hanezzzz00/dspi-pico2-diy/sticker/DSPi_bottom_sticker_QR_CZ.pdf

## DSPi – samolepka na dno krabičky (QR kód na návod)

Tiskněte ve SKUTEČNÉ VELIKOSTI (100 %), ne „přizpůsobit stránce“. Kontrolní měřítko dole musí mít přesně 50 mm. Velká samolepka má tvar dna krabičky (70,8 × 68,8 mm); rohové výřezy 10 × 10 mm jsou místo pro gumové nožičky. Potisk je 2 mm od řezu – okraj pro přesah laminovací fólie. Zalaminujte, pak stříhejte po přerušované čáře.
QR kód má zvýšenou korekci chyb (Q), přečte se i přes lesklou fólii. Před nalepením ho vyzkoušejte telefonem. Malé samolepky dole: jen QR kód, např. na kabel, krabičku od dílů nebo do šuplíku.

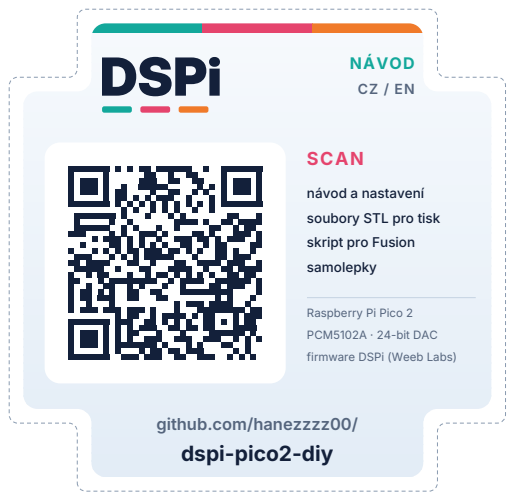
[picture p8: figure]
DSPi; NÁVOD; SCAN; návod a nastavení; soubory STL pro tisk; skript pro Fusion; samolepky; Raspberry Pi Pico 2; PCM5102A · 24-bit DAC; firmware DSPi (Weeb Labs); github.com/hanezzzz00/ dspi-pico2-diy
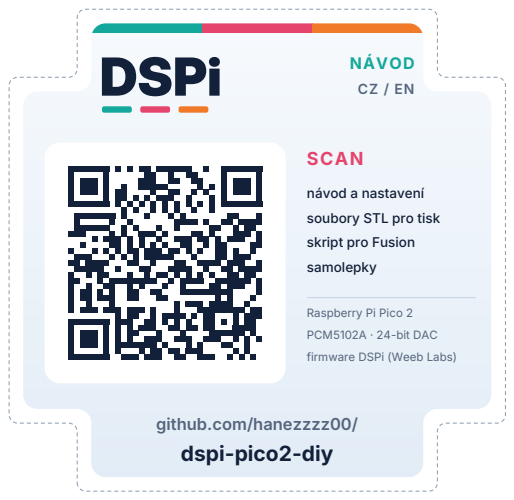
[picture p9: figure]
DSPi; NÁVOD; SCAN; návod a nastavení; soubory STL pro tisk; skript pro Fusion; samolepky; Raspberry Pi Pico 2; PCM5102A · 24-bit DAC; firmware DSPi (Weeb Labs); github.com/hanezzzz00/ dspi-pico2-diy
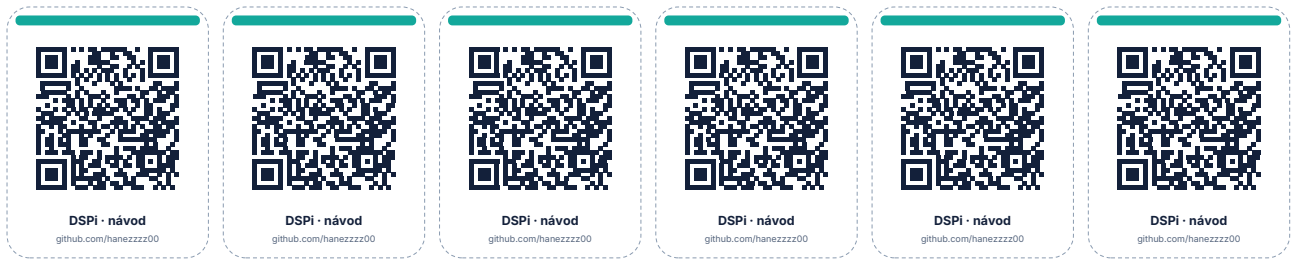
[picture p10: figure]
DSPi · návod; github.com/hanezzzz00

kontrolní měřítko 50 mm

https://github.com/hanezzzz00/dspi-pico2-diy · CC BY-SA 4.0
