hanezzzz00/dspi-pico2-diy/sticker/DSPi_bottom_sticker_QR_EN.pdf

## DSPi – enclosure bottom sticker (QR code to the guide)

Print at ACTUAL SIZE (100 %), not "fit to page". The scale bar below must measure exactly 50 mm.
The large sticker matches the enclosure bottom (70.8 × 68.8 mm); the 10 × 10 mm corner notches leave room for rubber feet. The print stops 2 mm before the cut – margin for the laminating film. Laminate, then cut along the dashed line.
The QR code uses higher error correction (Q) and reads even through glossy film. Test it with a phone before sticking.
Small stickers below: QR code only, e.g. for a cable, a parts box or a drawer.

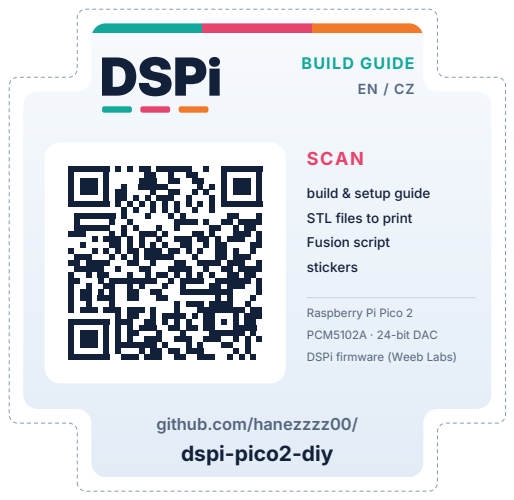
[picture p11: figure]
DSPi; BUILD GUIDE; SCAN; build & setup guide; STL files to print; Fusion script; stickers; Raspberry Pi Pico 2; PCM5102A · 24-bit DAC; DSPi firmware (Weeb Labs); github.com/hanezzzz00/ dspi-pico2-diy
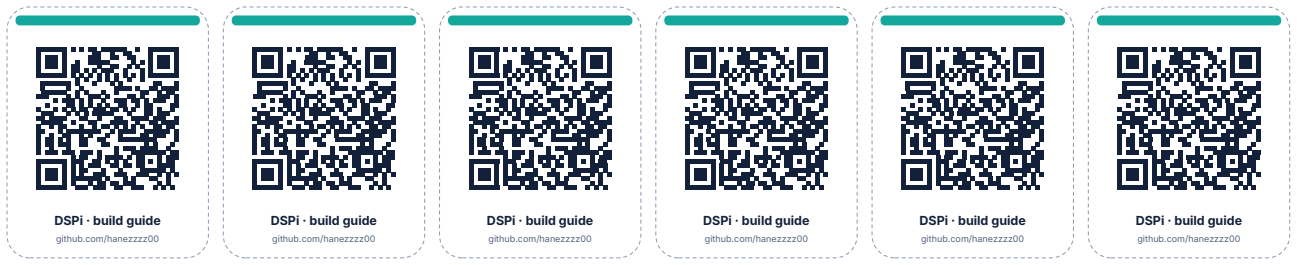
[picture p12: figure]
DSPi · build guide; github.com/hanezzzz00

50 mm scale bar

https://github.com/hanezzzz00/dspi-pico2-diy · CC BY-SA 4.0

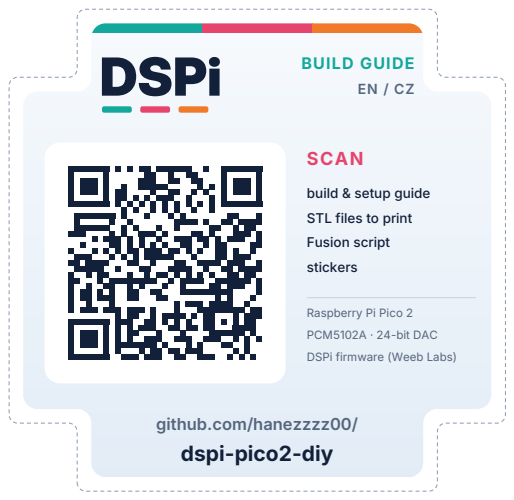
[picture p13: figure]
DSPi; BUILD GUIDE; SCAN; build & setup guide; STL files to print; Fusion script; stickers; Raspberry Pi Pico 2; PCM5102A · 24-bit DAC; DSPi firmware (Weeb Labs); github.com/hanezzzz00/ dspi-pico2-diy
