hanezzzz00/dspi-pico2-diy/sticker/DSPi_lid_sticker_light_CZ.pdf

## DSPi – samolepka na celé víko (světlá verze, pro laminování)

Tiskněte ve SKUTEČNÉ VELIKOSTI (100 %). Kontrolní měřítko dole musí mít přesně 50 mm.
Po zalaminování stříhejte podle šedé přerušované čáry – mezi potiskem a čarou zůstane 2 mm fólie, která drží zatavená. Rohové výřezy 10 × 10 mm nechávají volné šrouby víka. Kruhy POWER / SPK / HP jsou nad zahloubeními pro tlačítka – po jejich provrtání otvor v samolepce prořízněte skalpelem (nebo děrovačkou Ø 12 mm).

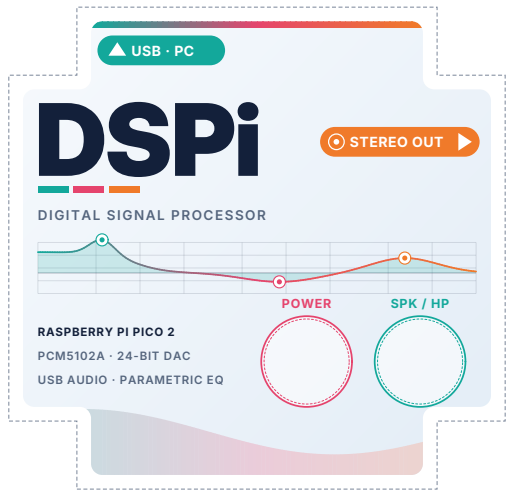
[picture p14: figure]
USB · PC DSPi; DIGITAL SIGNAL PROCESSOR; STEREO OUT; POWER; SPK / HP; RASPBERRY PI PICO 2; PCM5102A · 24-BIT DAC; USB AUDIO · PARAMETRIC EQ
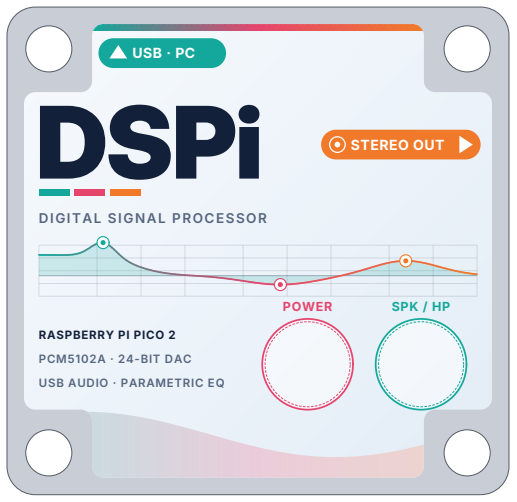
[picture p15: figure]
USB · PC DSPi; DIGITAL SIGNAL PROCESSOR; STEREO OUT; POWER; SPK / HP; RASPBERRY PI PICO 2; PCM5102A · 24-BIT DAC; USB AUDIO · PARAMETRIC EQ

kontrolní měřítko 50 mm

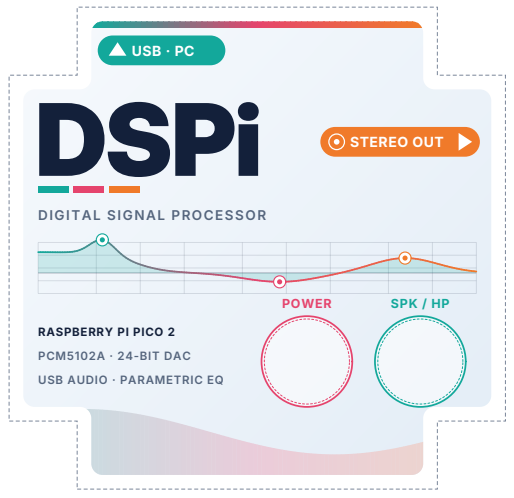
[picture p16: figure]
USB · PC DSPi; DIGITAL SIGNAL PROCESSOR; STEREO OUT; POWER; SPK / HP; RASPBERRY PI PICO 2; PCM5102A · 24-BIT DAC; USB AUDIO · PARAMETRIC EQ

Náhled na víku (1:1, pohled shora, přední hrana dole; USB vzadu, jack vpravo)
