hanezzzz00/dspi-pico2-diy/sticker/DSPi_lid_sticker_light_EN.pdf

## DSPi – full-lid sticker (light version, for laminating)

Print at ACTUAL SIZE (100 %). The scale bar below must measure exactly 50 mm.
After laminating, cut along the grey dashed line – 2 mm of sealed film remains between the print and the cut.
The 10 × 10 mm corner notches leave the lid screws free. The POWER / SPK / HP rings sit over the button recesses – after drilling them, cut the sticker open with a scalpel (or a Ø 12 mm hole punch).

USB · PC DSPi; DIGITAL SIGNAL PROCESSOR; STEREO OUT; POWER; SPK / HP; RASPBERRY PI PICO 2; PCM5102A · 24-BIT DAC; USB AUDIO · PARAMETRIC EQ
USB · PC DSPi; DIGITAL SIGNAL PROCESSOR; STEREO OUT; POWER; SPK / HP; RASPBERRY PI PICO 2; PCM5102A · 24-BIT DAC; USB AUDIO · PARAMETRIC EQ

50 mm scale bar

USB · PC DSPi; DIGITAL SIGNAL PROCESSOR; STEREO OUT; POWER; SPK / HP; RASPBERRY PI PICO 2; PCM5102A · 24-BIT DAC; USB AUDIO · PARAMETRIC EQ

Preview on the lid (1:1, top view, front edge at the bottom; USB at the back, jack on the right)
