hanezzzz00/dspi-pico2-diy/enclosure/stl/DSPi_krabicka_viko.stl

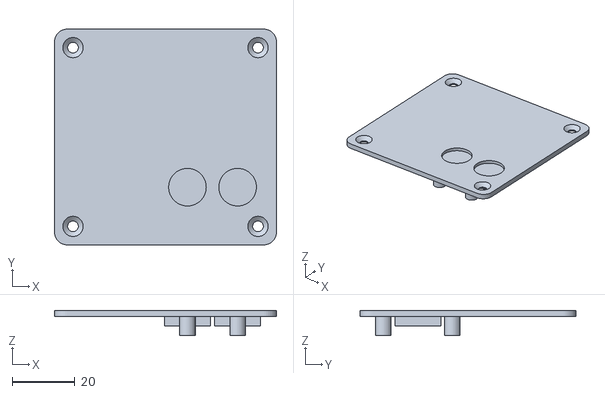
[picture p55: CAD file, 2026-10-25]
enclosure/stl/DSPi_krabicka_viko.stl
70.8 x 68.8 x 8.00
