hanezzzz00/dspi-pico2-diy/enclosure/stl/DSPi_krabicka_spodek.stl

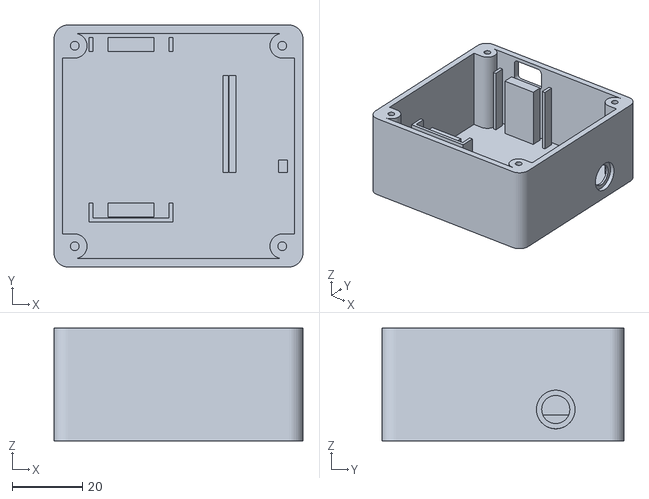
[picture p56: CAD file, 2026-10-25]
enclosure/stl/DSPi_krabicka_spodek.stl
70.8 x 68.8 x 32.0
