hanezzzz00/dspi-pico2-diy/images/assembled.jpg

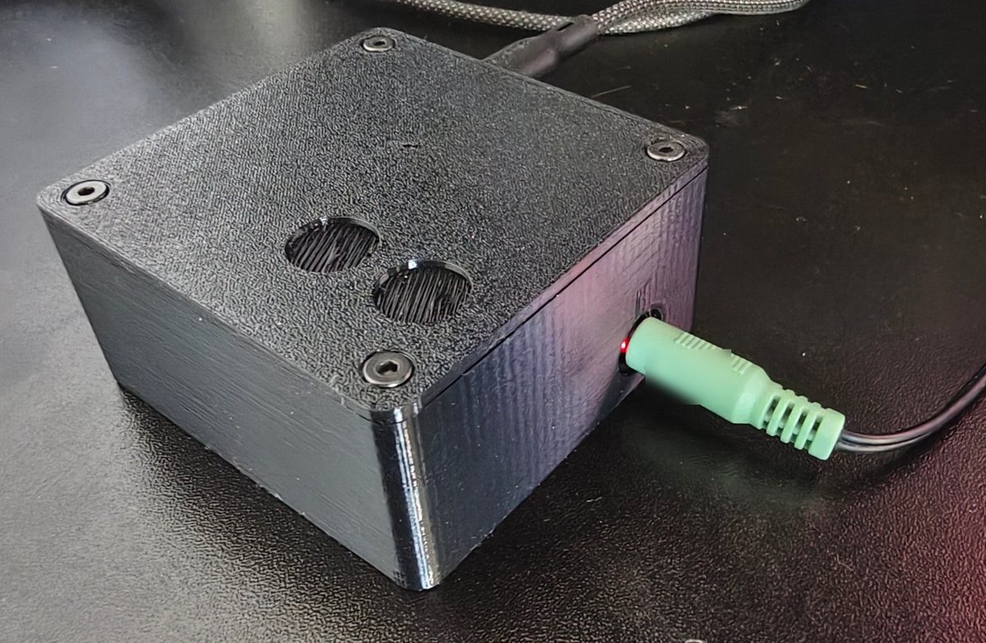
images/assembled.jpg
