hanezzzz00/dspi-pico2-diy/sticker/DSPi_lid_sticker_dark_CZ.pdf

## DSPi – samolepka na víko krabičky

Tiskněte ve SKUTEČNÉ VELIKOSTI (100 %, bez „Přizpůsobit stránce“). Ověřte měřítkem dole: musí mít přesně 50 mm.
Řežte podle značek v rozích – barva přesahuje 2 mm za řez, takže drobná nepřesnost nevadí. Hlavní samolepka 50,8 × 40,8 mm, proužek pod tlačítka 27,8 × 7,4 mm (lepte až po osazení tlačítek). Několik kusů navíc pro případ pokaženého řezu.
100 | 1k | 10k

# DSPi

DIGITAL SIGNAL PROCESSOR

USB · PC

STEREO OUT

RASPBERRY PI PICO 2 · PCM5102A | 24-BIT DAC
100 | 1k | 10k

# DSPi

DIGITAL SIGNAL PROCESSOR

USB · PC

STEREO OUT

RASPBERRY PI PICO 2 · PCM5102A | 24-BIT DAC
100 | 1k | 10k

# DSPi

DIGITAL SIGNAL PROCESSOR

USB · PC

STEREO OUT

RASPBERRY PI PICO 2 · PCM5102A | 24-BIT DAC
100 | 1k | 10k

# DSPi

DIGITAL SIGNAL PROCESSOR

USB · PC

STEREO OUT

RASPBERRY PI PICO 2 · PCM5102A | 24-BIT DAC
100 | 1k | 10k

# DSPi

DIGITAL SIGNAL PROCESSOR

USB · PC

STEREO OUT

RASPBERRY PI PICO 2 · PCM5102A | 24-BIT DAC
100 | 1k | 10k

# DSPi

DIGITAL SIGNAL PROCESSOR

USB · PC

STEREO OUT

RASPBERRY PI PICO 2 · PCM5102A | 24-BIT DAC
POWER | SPK / HP | POWER | SPK / HP | POWER | SPK / HP

kontrolní měřítko 50 mm

Tip: tiskněte na samolepicí fotopapír nebo samolepicí fólii; matný papír přetřete lakem nebo přelepte průhlednou fólií. Umístění na víko ukazuje strana 2 (také 1:1 – můžete ji vystřihnout a použít jako šablonu).

## Umístění na víko (měřítko 1:1, pohled shora, přední hrana dole)

# DSPi

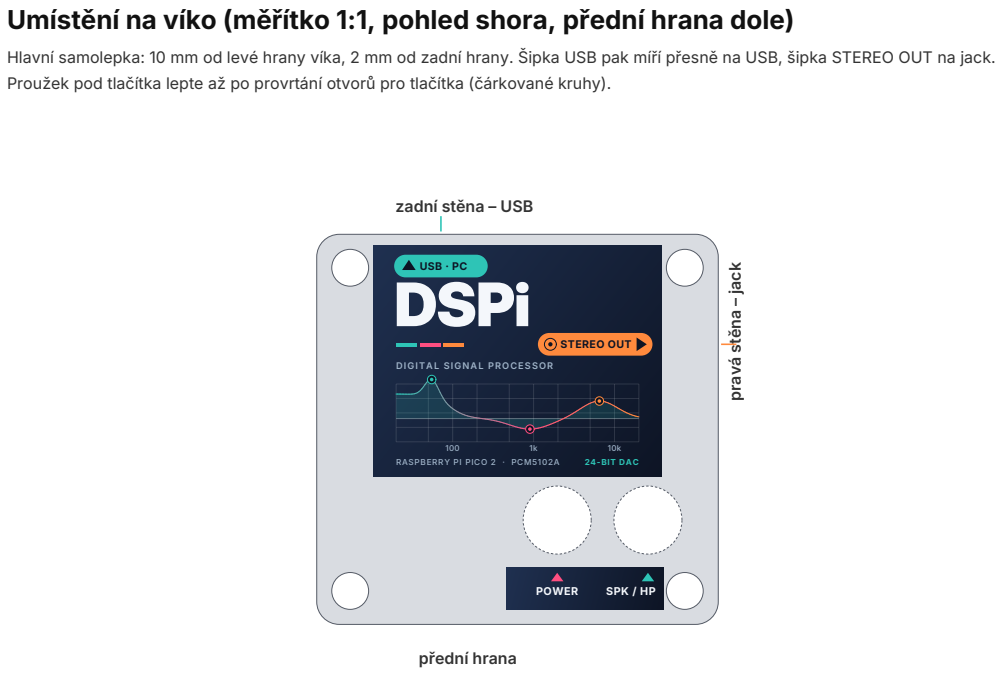
[picture p64: page 2]
USB · PC; STEREO OUT; RASPBERRY PI PICO 2 · PCM5102A; 24-BIT DAC; POWER; SPK / HP; přední hrana

Hlavní samolepka: 10 mm od levé hrany víka, 2 mm od zadní hrany. Šipka USB pak míří přesně na USB, šipka STEREO OUT na jack.
Proužek pod tlačítka lepte až po provrtání otvorů pro tlačítka (čárkované kruhy).

zadní stěna – USB

pravá stěna – jack

DIGITAL SIGNAL PROCESSOR
