hanezzzz00/dspi-pico2-diy/sticker/DSPi_lid_sticker_dark_EN.pdf

## DSPi – enclosure lid sticker

# DSPi

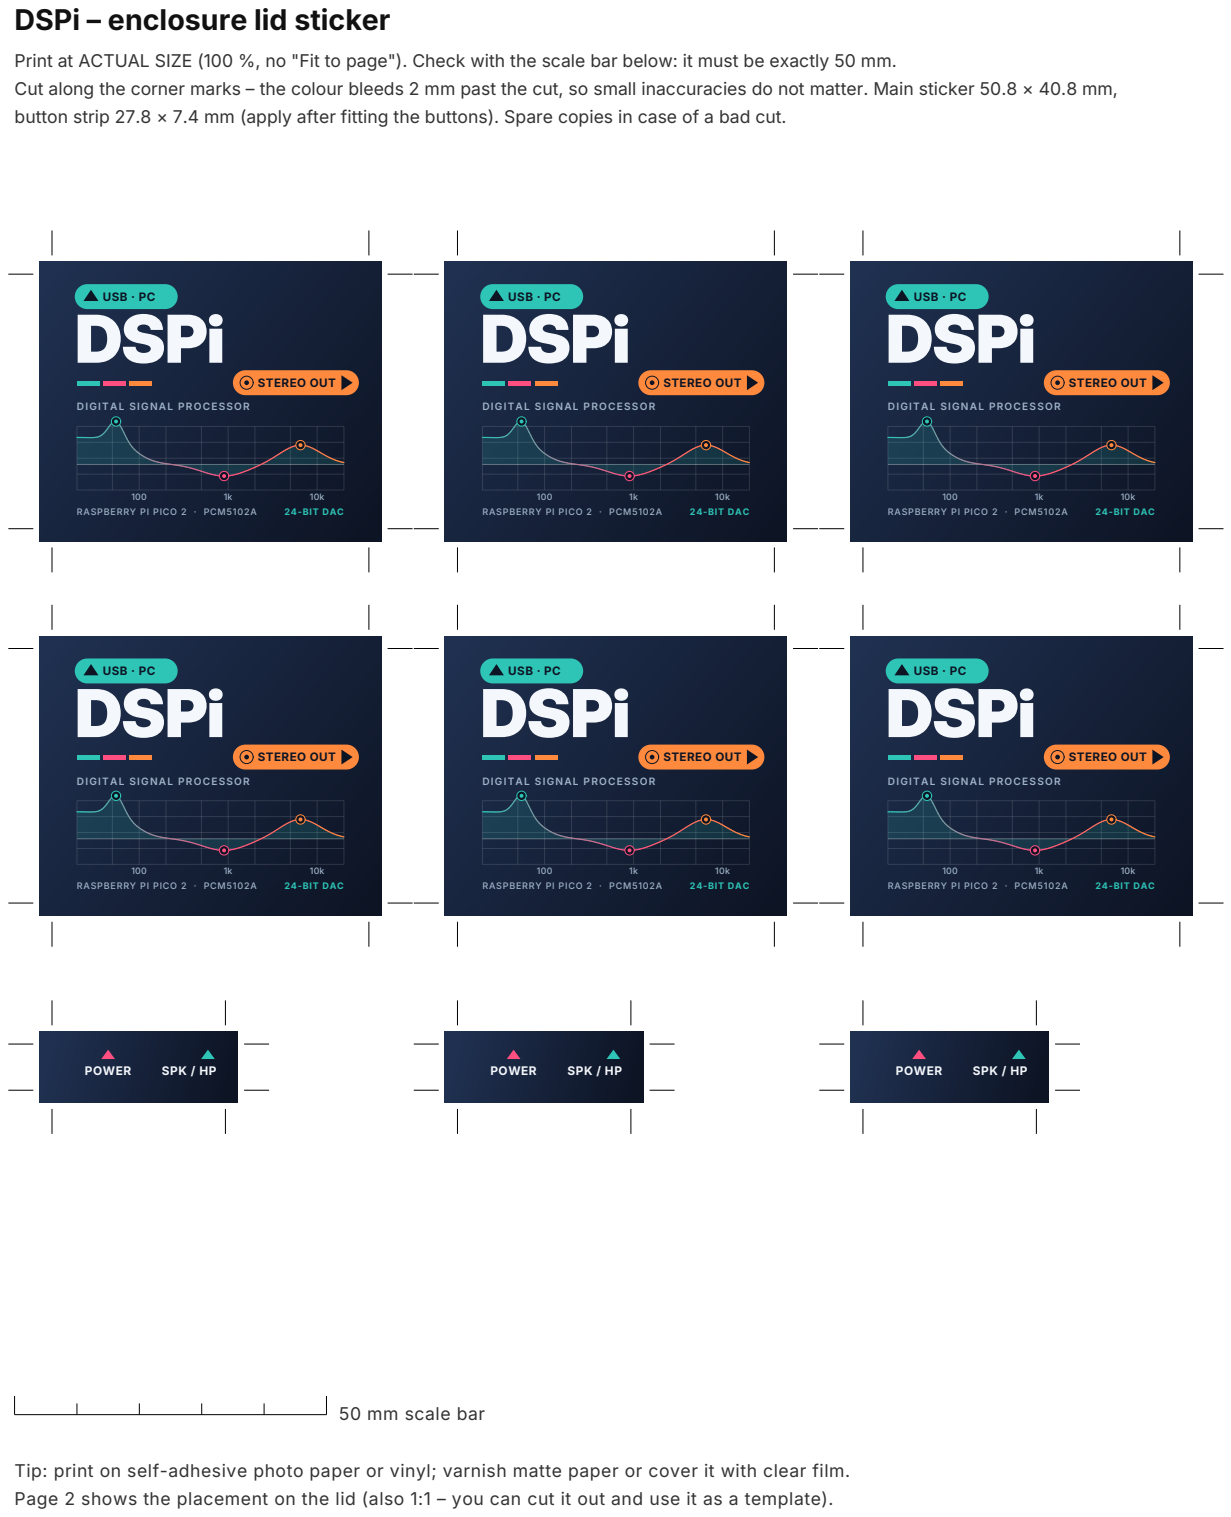
[picture p65: page 1]
USB · PC; STEREO OUT; RASPBERRY PI PICO 2 · PCM5102A; 24-BIT DAC; DSPi; POWER; SPK / HP

Print at ACTUAL SIZE (100 %, no "Fit to page"). Check with the scale bar below: it must be exactly 50 mm.
Cut along the corner marks – the colour bleeds 2 mm past the cut, so small inaccuracies do not matter. Main sticker 50.8 × 40.8 mm,
button strip 27.8 × 7.4 mm (apply after fitting the buttons). Spare copies in case of a bad cut.

DIGITAL SIGNAL PROCESSOR

50 mm scale bar

Tip: print on self-adhesive photo paper or vinyl; varnish matte paper or cover it with clear film.
Page 2 shows the placement on the lid (also 1:1 – you can cut it out and use it as a template).

## Placement on the lid (1:1, top view, front edge at the bottom)

# DSPi

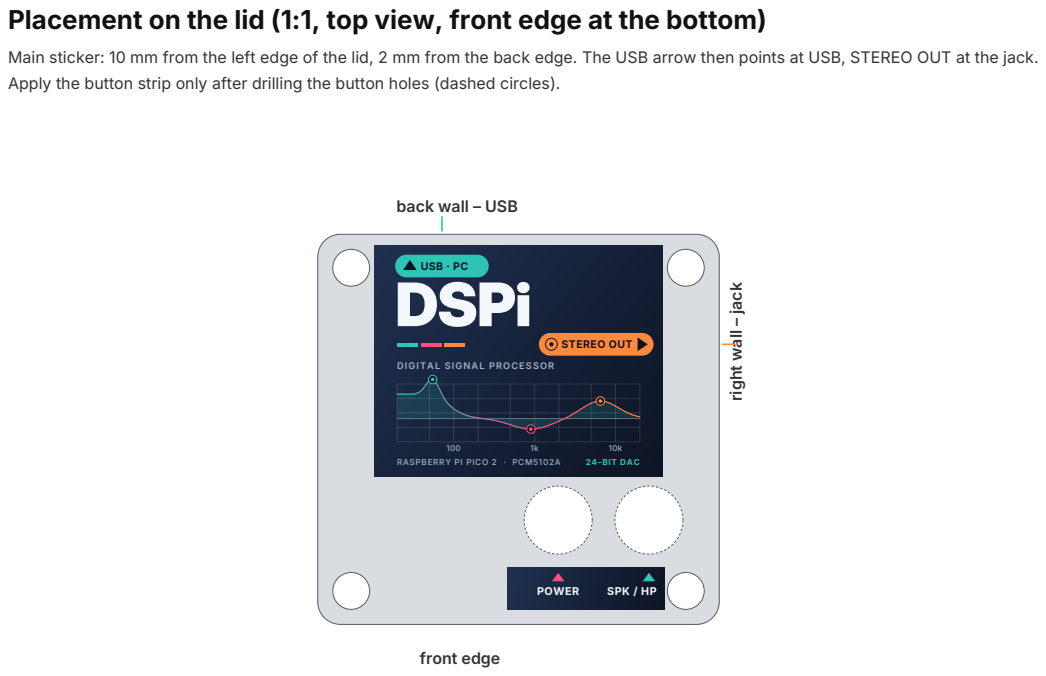
[picture p66: page 2]
USB · PC; STEREO OUT; RASPBERRY PI PICO 2 · PCM5102A; 24-BIT DAC; POWER; SPK / HP; front edge

Main sticker: 10 mm from the left edge of the lid, 2 mm from the back edge. The USB arrow then points at USB, STEREO OUT at the jack.
Apply the button strip only after drilling the button holes (dashed circles).

back wall – USB

right wall – jack

DIGITAL SIGNAL PROCESSOR
