hanezzzz00/dspi-pico2-diy/(commit log)

2026-10-25 Add enclosure STL files (v3)
    [DSPi_krabicka_spodek.stl, DSPi_krabicka_viko.stl]
2026-10-25 Sticker sources: add EN/CZ language switch
